arhunt35/shakelet/README.md

# shakelet
Code and documentation for Shakelet project
