arhunt35/shakelet/Eagle-and-Gerber-Files/Eagle-boards-and-schematics/Sensor v10.brd

## EAGLE design Eagle-and-Gerber-Files/Eagle-boards-and-schematics/Sensor v10.brd (2016-10-01)

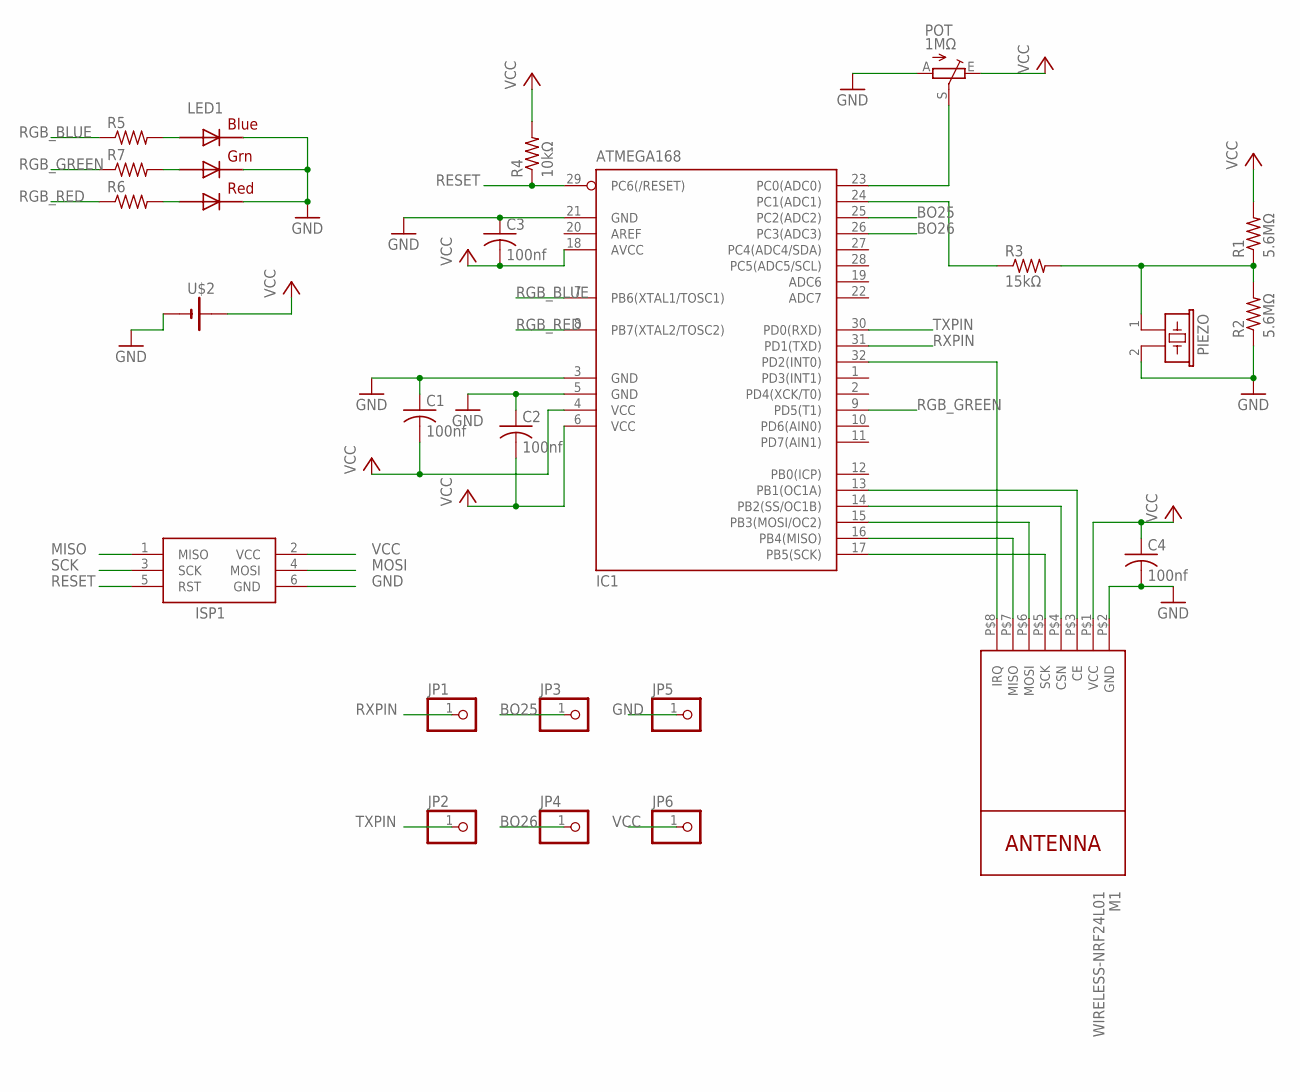
[picture p8: schematic Sensor v10.sch]

Parts:
C1, C2, C3, C4: 100nf; C0805
IC1: ATMEGA168; TQFP32-08
ISP1: AVRISP-6; AVRISP
JP1, JP2, JP3, JP4, JP5, JP6: PINHD-1X1; 1X01
LED1: RGBLED5050
M1: WIRELESS-NRF24L01
PIEZO: EFBAA40D101
POT: 1MΩ; CA6V
R1, R2: 5.6MΩ; R0805
R3: 15kΩ; R0805
R4: 10kΩ; R0805
R5, R6, R7: R-US_R0805; R0805
U$2: CR2032SMT; CR2032-SMD

Connections:
BO25: IC1.25 (PC2(ADC2)), JP3.1
BO26: IC1.26 (PC3(ADC3)), JP4.1
GND: C1.1, C2.1, C3.1, C4.2, IC1.3 (GND), IC1.5 (GND), IC1.21 (GND), ISP1.6 (GND), JP5.1, LED1.4 (BLUE_C), LED1.5 (RED_C), LED1.6 (GREEN_C), M1.P$2 (GND), PIEZO.2, POT.A, R2.1, U$2.-$1 (-)
MISO: IC1.16 (PB4(MISO)), ISP1.1 (MISO), M1.P$7 (MISO)
MOSI: IC1.15 (PB3(MOSI/OC2)), ISP1.4 (MOSI), M1.P$6 (MOSI)
unnamed: IC1.13 (PB1(OC1A)), M1.P$3 (CE)
unnamed: IC1.14 (PB2(SS/OC1B)), M1.P$4 (CSN)
unnamed: LED1.3 (BLUE_A), R5.2
unnamed: LED1.1 (GREEN_A), R7.2
unnamed: LED1.2 (RED_A), R6.2
unnamed: IC1.32 (PD2(INT0)), M1.P$8 (IRQ)
unnamed: IC1.23 (PC0(ADC0)), POT.S
unnamed: PIEZO.1, R1.1, R2.2, R3.2
unnamed: IC1.24 (PC1(ADC1)), R3.1
RESET: IC1.29 (PC6(/RESET)), ISP1.5 (RST), R4.1
RGB_BLUE: IC1.7 (PB6(XTAL1/TOSC1)), R5.1
RGB_GREEN: IC1.9 (PD5(T1)), R7.1
RGB_RED: IC1.8 (PB7(XTAL2/TOSC2)), R6.1
RXPIN: IC1.31 (PD1(TXD)), JP1.1
SCK: IC1.17 (PB5(SCK)), ISP1.3 (SCK), M1.P$5 (SCK)
TXPIN: IC1.30 (PD0(RXD)), JP2.1
VCC: C1.2, C2.2, C3.2, C4.1, IC1.4 (VCC), IC1.6 (VCC), IC1.18 (AVCC), ISP1.2 (VCC), JP6.1, M1.P$1 (VCC), POT.E, R1.2, R4.2, U$2.+$1 (+1)

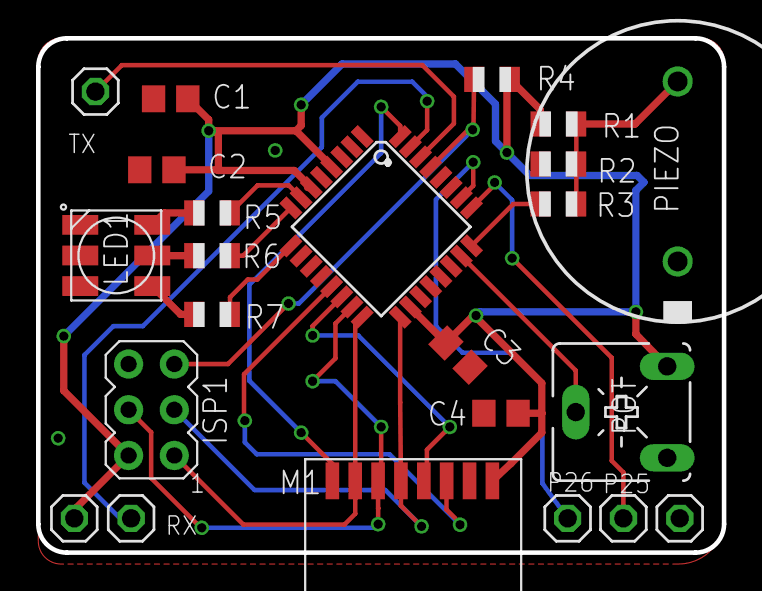
[picture p9: board Sensor v10.brd from above]

Board: 2 copper layers, 38.1 x 28.6 mm, 24 parts (1 on the bottom side), 22 nets.
