arhunt35/shakelet/Eagle-and-Gerber-Files/Eagle-boards-and-schematics/Bracelet v3.brd

## EAGLE design Eagle-and-Gerber-Files/Eagle-boards-and-schematics/Bracelet v3.brd (2016-10-01)

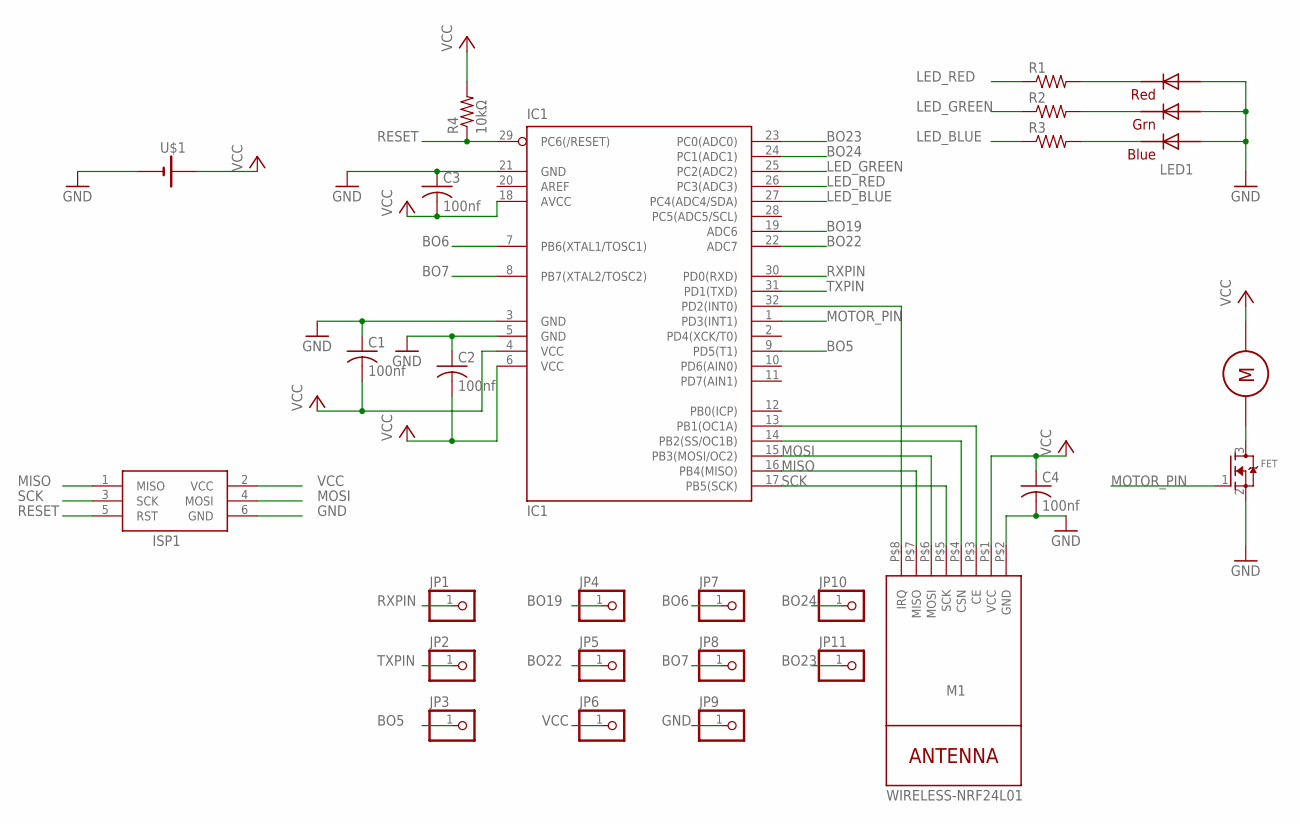
[picture p10: schematic Bracelet v3.sch]

Parts:
C1, C2, C3, C4: 100nf; C0805
FET: MOSFET-NREFLOW; SOT23
IC1: IC1; TQFP32-08
ISP1: AVRISP-6; AVRISP
JP1, JP2, JP3, JP4, JP5, JP6, JP7, JP8, JP9, JP10, JP11: PINHD-1X1; 1X01
LED1: RGBLED5050
M1: WIRELESS-NRF24L01
MOTOR: Motor; VIBRATING-MOTOR
R1, R2, R3: R-US_R0805; R0805
R4: 10kΩ; R0805
U$1: CR2032SMT; CR2032-SMD

Connections:
BO5: IC1.9 (PD5(T1)), JP3.1
BO6: IC1.7 (PB6(XTAL1/TOSC1)), JP7.1
BO7: IC1.8 (PB7(XTAL2/TOSC2)), JP8.1
BO19: IC1.19 (ADC6), JP4.1
BO22: IC1.22 (ADC7), JP5.1
BO23: IC1.23 (PC0(ADC0)), JP11.1
BO24: IC1.24 (PC1(ADC1)), JP10.1
GND: C1.1, C2.1, C3.1, C4.2, FET.2 (S), IC1.3 (GND), IC1.5 (GND), IC1.21 (GND), ISP1.6 (GND), JP9.1, LED1.1 (GREEN_A), LED1.2 (RED_A), LED1.3 (BLUE_A), M1.P$2 (GND), U$1.-$1 (-)
LED_BLUE: IC1.27 (PC4(ADC4/SDA)), R3.1
LED_GREEN: IC1.25 (PC2(ADC2)), R2.1
LED_RED: IC1.26 (PC3(ADC3)), R1.1
MISO: IC1.16 (PB4(MISO)), ISP1.1 (MISO), M1.P$7 (MISO)
MOSI: IC1.15 (PB3(MOSI/OC2)), ISP1.4 (MOSI), M1.P$6 (MOSI)
MOTOR_PIN: FET.1 (G), IC1.1 (PD3(INT1))
unnamed: IC1.13 (PB1(OC1A)), M1.P$3 (CE)
unnamed: IC1.14 (PB2(SS/OC1B)), M1.P$4 (CSN)
unnamed: LED1.5 (RED_C), R1.2
unnamed: LED1.6 (GREEN_C), R2.2
unnamed: LED1.4 (BLUE_C), R3.2
unnamed: IC1.32 (PD2(INT0)), M1.P$8 (IRQ)
unnamed: FET.3 (D), MOTOR.P$2
RESET: IC1.29 (PC6(/RESET)), ISP1.5 (RST), R4.1
RXPIN: IC1.30 (PD0(RXD)), JP1.1
SCK: IC1.17 (PB5(SCK)), ISP1.3 (SCK), M1.P$5 (SCK)
TXPIN: IC1.31 (PD1(TXD)), JP2.1
VCC: C1.2, C2.2, C3.2, C4.1, IC1.4 (VCC), IC1.6 (VCC), IC1.18 (AVCC), ISP1.2 (VCC), JP6.1, M1.P$1 (VCC), MOTOR.NAME, R4.2, U$1.+$1 (+1)

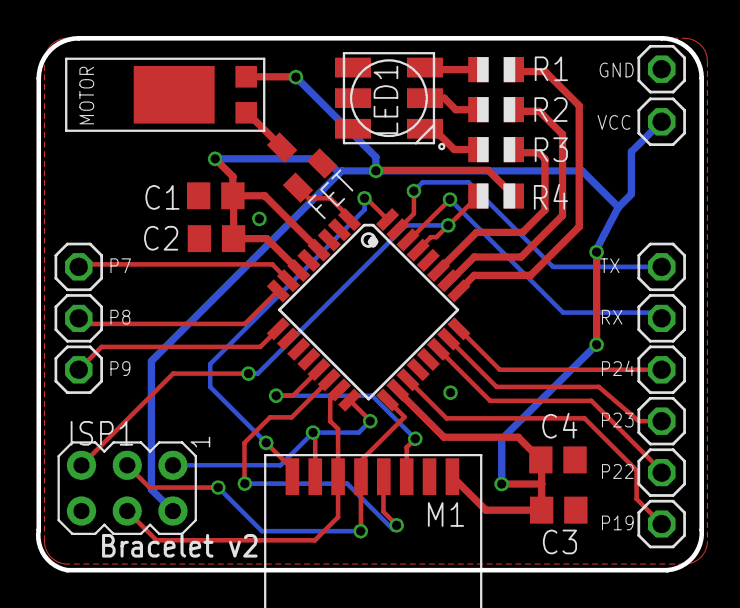
[picture p11: board Bracelet v3.brd from above]

Board: 2 copper layers, 36.9 x 29.5 mm, 26 parts (1 on the bottom side), 26 nets.
